danielpchamoun/DMClock/(commit log)

2024-06-12 adding mplabxide init files
    [DMClock.kicad_pcb, DMClock.kicad_sch, mcu.kicad_sch, power.kicad_sch, ui.kicad_sch]
2024-06-14 more modules added, still need to add a lot of footprints and see if there exist any sd card libraries for use with i2s
    [DMClock.kicad_pcb, DMClock.kicad_sch, mcu.kicad_sch, power.kicad_sch, ui.kicad_sch]
2024-06-14 added more to schematic, hv622
    [mcu.kicad_sch, ui.kicad_sch]
2024-06-16 need to work on hvps logic converter
    [DMClock.kicad_pcb, DMClock.kicad_sch, mcu.kicad_sch, power.kicad_sch, ui.kicad_sch]
2024-06-20 just need to finish pcb
    [DMClock.kicad_pcb, DMClock.kicad_sch, mcu.kicad_sch, power.kicad_sch, ui.kicad_sch]
2024-06-21 added test points, need to fix commas
    [DMClock.kicad_pcb, ui.kicad_sch]
2024-06-21 started adding traces to hvps logic converter
    [DMClock.kicad_pcb, ui.kicad_sch]
2024-06-22 added so much: traces for first two tubes, net assignments for high voltage traces/vias
    [DMClock.kicad_pcb]
2024-06-23 first layer done, needs optimizations
    [DMClock.kicad_pcb, ui.kicad_sch]
2024-06-23 redid a bit of the first layer. still need to finish redoing
    [DMClock.kicad_pcb]
2024-06-23 update second layer finalizations
    [DMClock.kicad_pcb, DMClock.kicad_sch]
2024-06-24 finished second layer. need to finalize both first and second (double checking everything looks right, double check pwm pins, add ground plane, and finally send to pcbway. im kinda slow but hopefully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
    [DMClock.kicad_pcb, DMClock.kicad_sch, mcu.kicad_sch, power.kicad_sch]
2024-06-25 finished v.1
    [DMClock.kicad_pcb, mcu.kicad_sch, ui.kicad_sch]
2024-06-25 fixed orientation error
    [DMClock.kicad_pcb]
2024-06-26 added gerbers
    [DMClockPanel-B_Cu.gbl, DMClockPanel-B_Mask.gbs, DMClockPanel-B_Paste.gbp, DMClockPanel-B_Silkscreen.gbo, DMClockPanel-Edge_Cuts.gm1, DMClockPanel-F_Cu.gtl, DMClockPanel-F_Mask.gts, DMClockPanel-F_Paste.gtp]
2024-06-26 v1 complete
    [DMClock.csv]
2024-07-01 initial mpe files
    [mcu.kicad_sch]
2024-07-02 fixed eeprom by using __eprom globals instead of mcc (mcc only used for newer pic chips)
    [main.c]
2024-07-07 added interrupts, need to define some functions and actually implement still
2024-08-11 started calculating period frequencies for pwm module
2024-08-21 notes correct, need to add lower frequencies through the ccp module using loops and interrupts
    [main.c]
2024-08-26 might move from 4 to 3 buttons to add another piezo channel
2024-08-26 need to add timer6 implementation
    [mcu.kicad_sch]
2024-08-28 found a better sound for the foot drum, just need to fix the timing tomorrow
    [main.c]
2024-09-13 merging kicad and mpelab
2024-09-23 updated buck converter
    [DMClock.kicad_pcb, DMClock.kicad_sch, mcu.kicad_sch, power.kicad_sch, ui.kicad_sch]
2024-09-23 v2 board finished
    [DMClock.kicad_pcb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]
2024-10-08 2nd version working, need to work on i2c code now
    [DMClock.kicad_pcb]
2024-10-09 i2c wip
2024-10-17 more tests, waiting for pin header to arrive so until then ill just work on adding more alarms
2024-12-01 testing from new linux device
